SM-15/ERB-BSPD/Ltspice/README.md

# ERB-BSPD
BSPD Circuit and PCB by E-Racing Bergamo
