SM-15/ERB-BSPD/docs/Logic block diagram.png

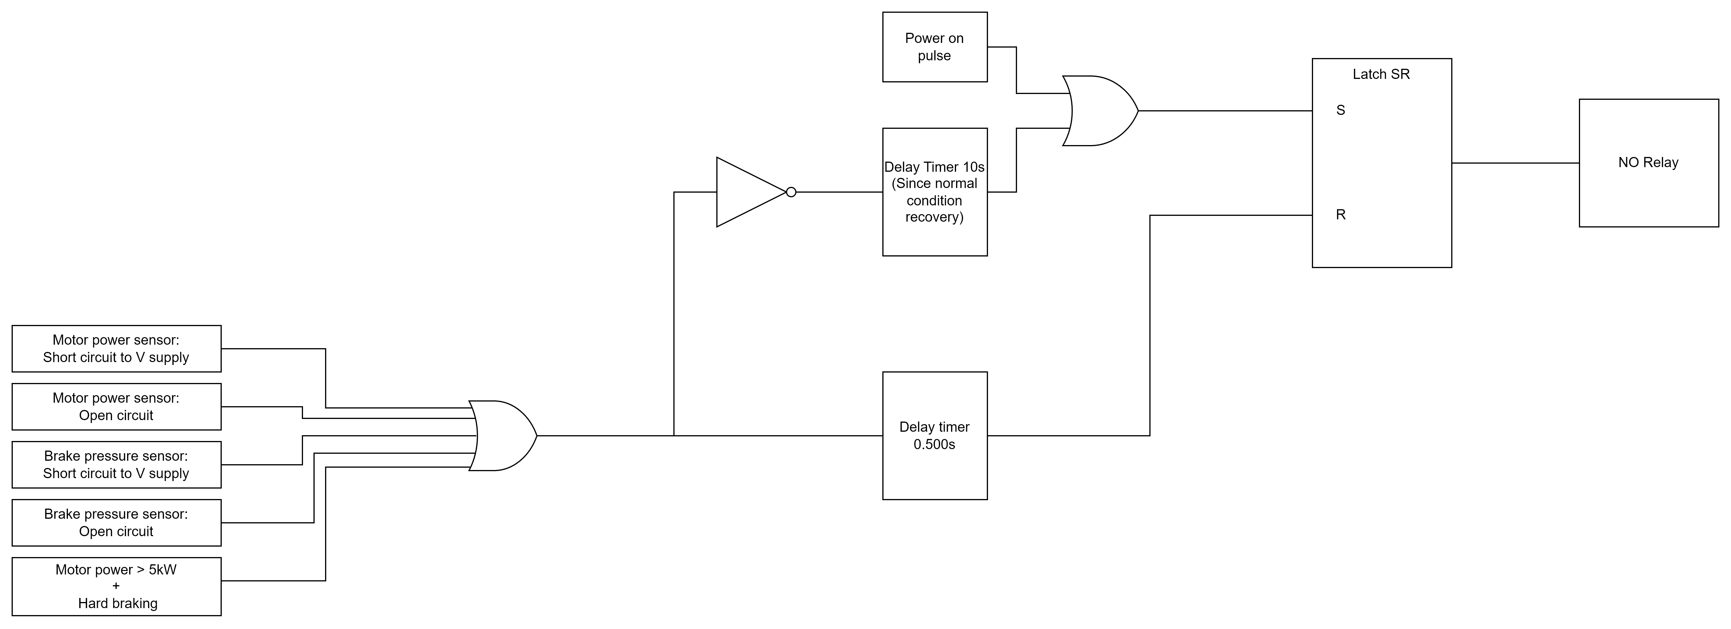
docs/Logic block diagram.png
