SM-15/ERB-BSPD/schemablocchi.png

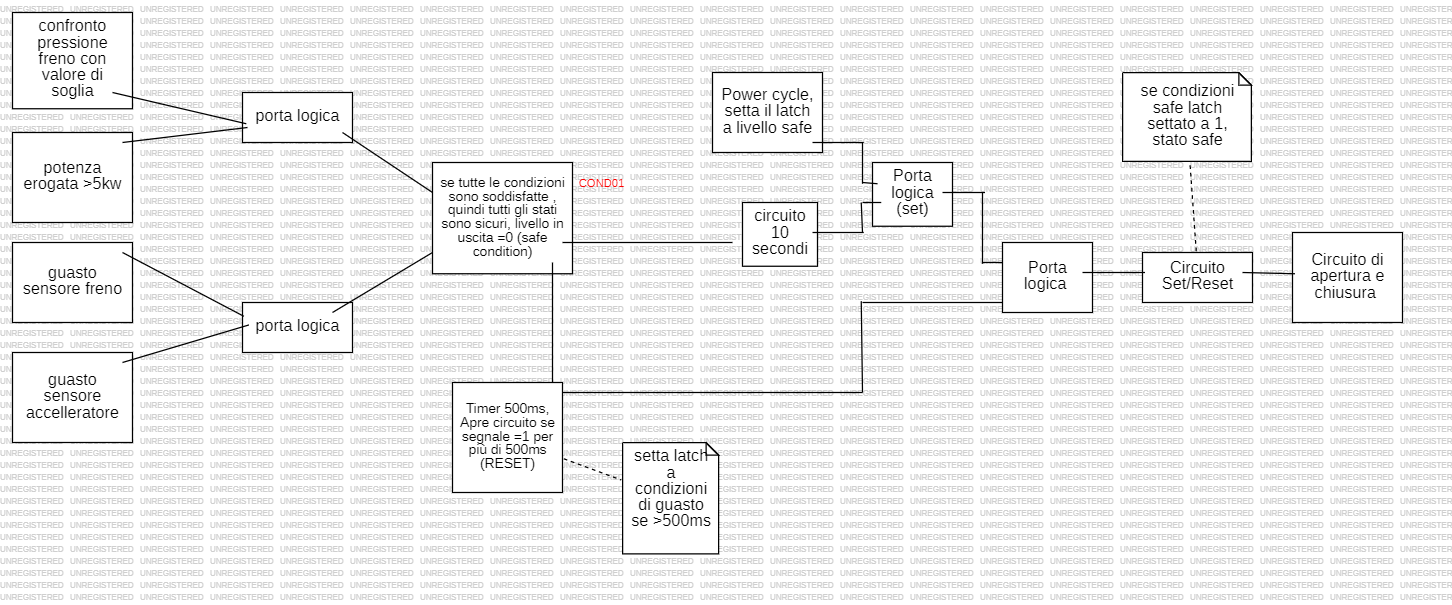
schemablocchi.png
