SM-15/ERB-BSPD/docs/System component overview.png

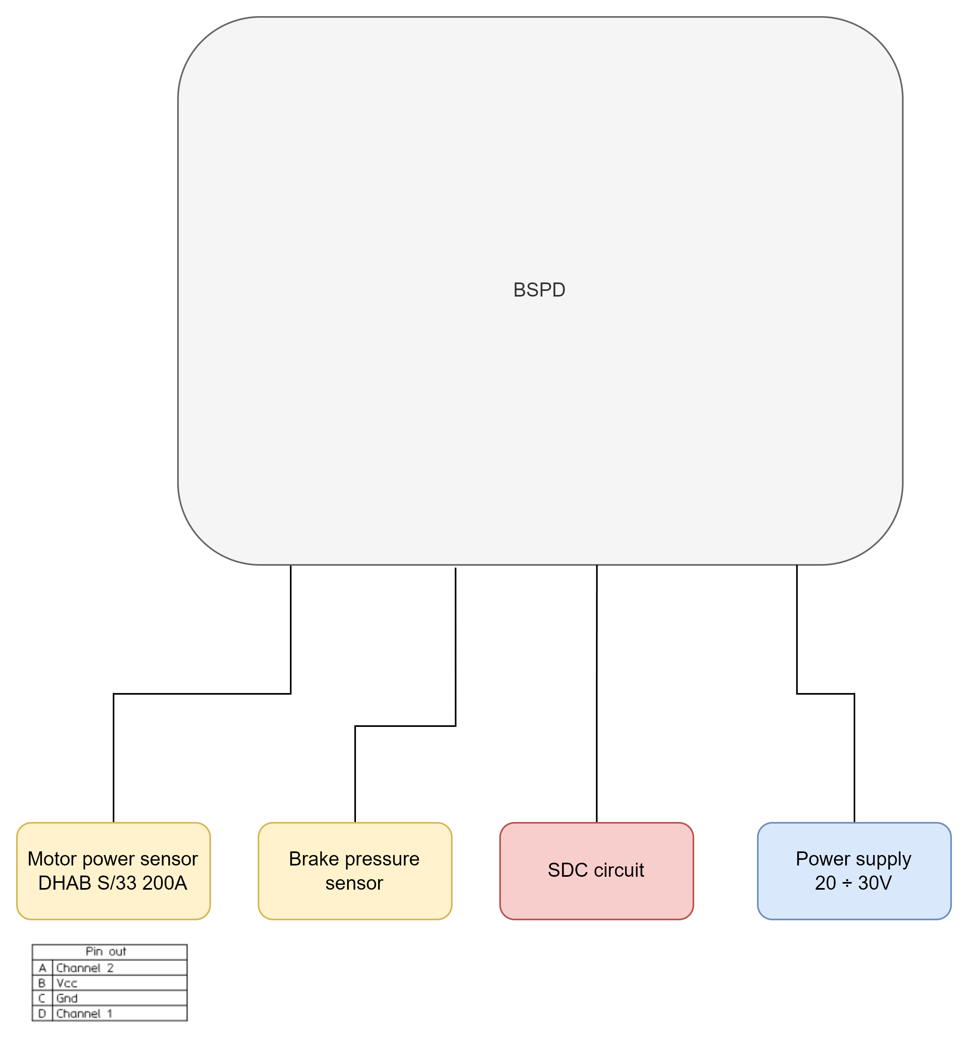
docs/System component overview.png
