SM-15/ERB-BSPD/docs/Schematic_ERB-BSPD_2024-05-10.pdf

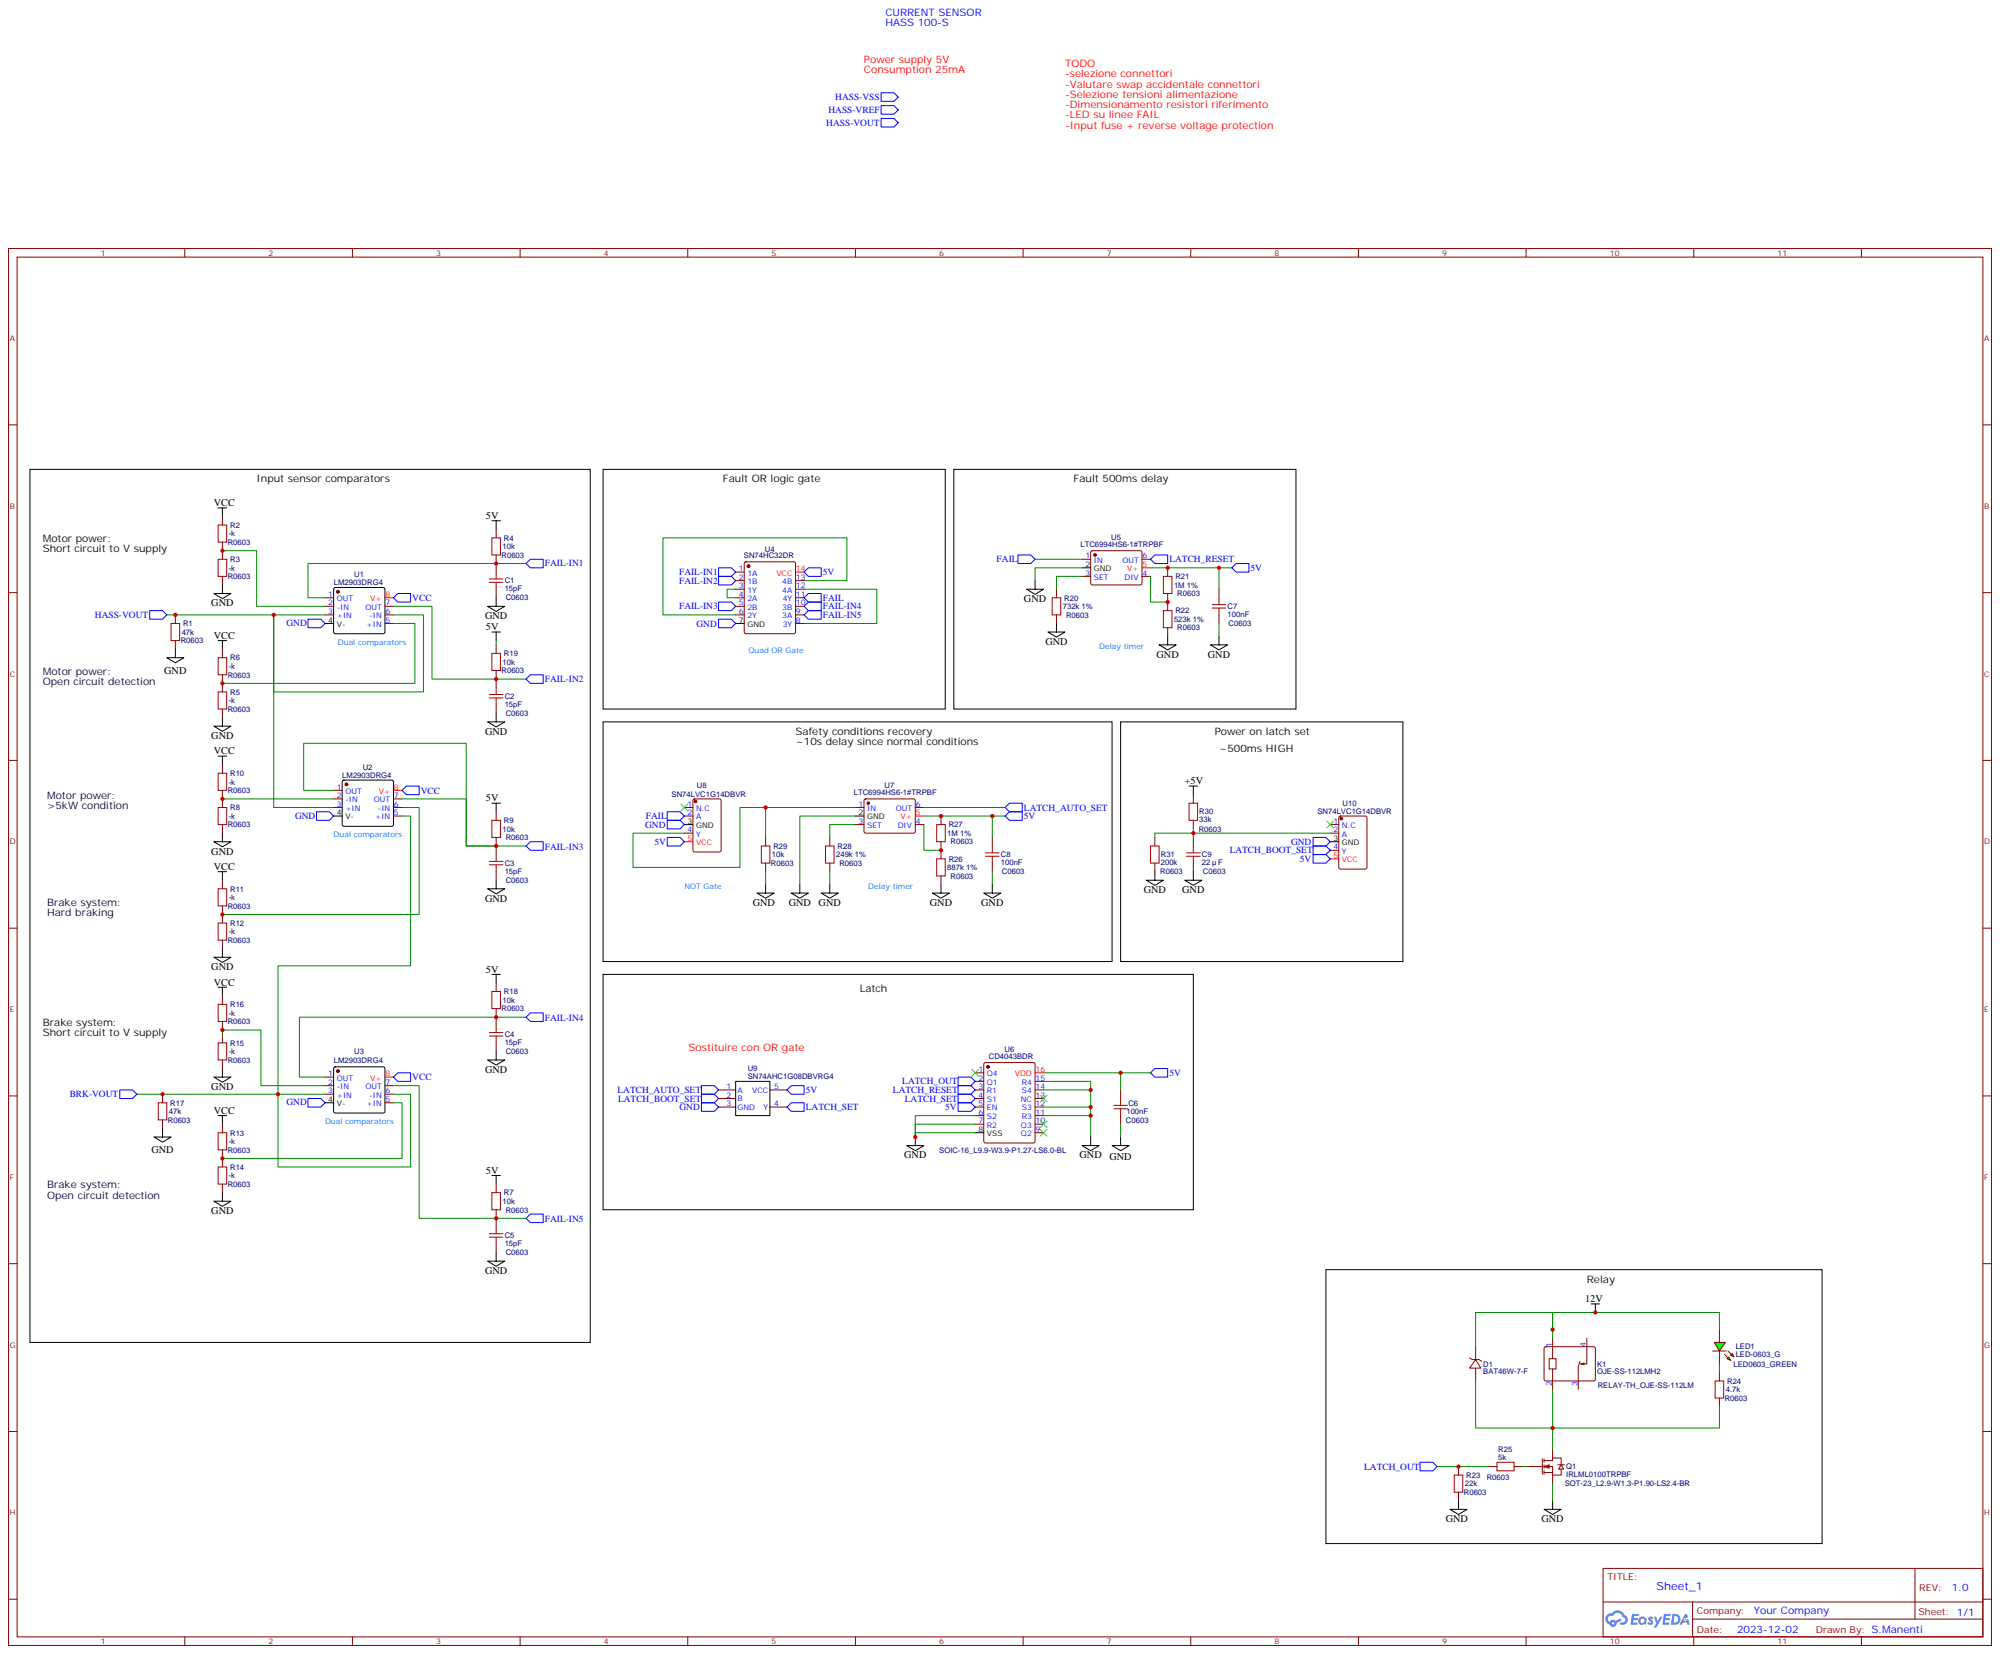
[picture p20: page 1]

TODO
-selezione connettori
-Valutare swap accidentale connettori
-Selezione tensioni alimentazione
-Dimensionamento resistori riferimento
-LED su linee FAIL
-Input fuse + reverse voltage protection

Motor power:
Short circuit to V supply

Delay timer Quad OR Gate

Safety conditions recovery
~10s delay since normal conditions

Power on latch set
~500ms HIGH

Brake system:

Sostituire con OR gate
