SM-15/ERB-BSPD/docs/BSPD LtSpice Circuit v8.pdf

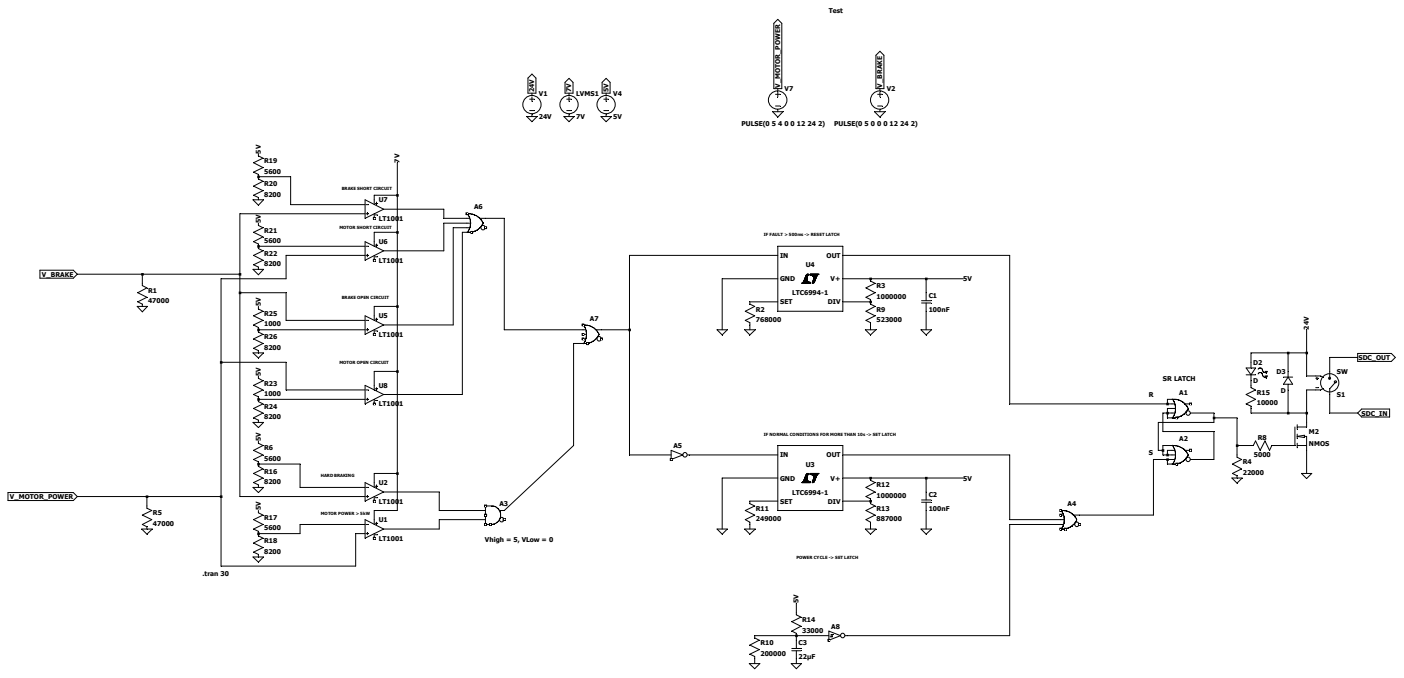
[picture p21: page 1]

IF FAULT > 500ms -> RESET LATCH

IF NORMAL CONDITIONS FOR MORE THAN 10s -> SET LATCH

POWER CYCLE -> SET LATCH
