SM-15/ERB-BSPD/Ltspice/BSPD_ERB.pdf

## LVMS2

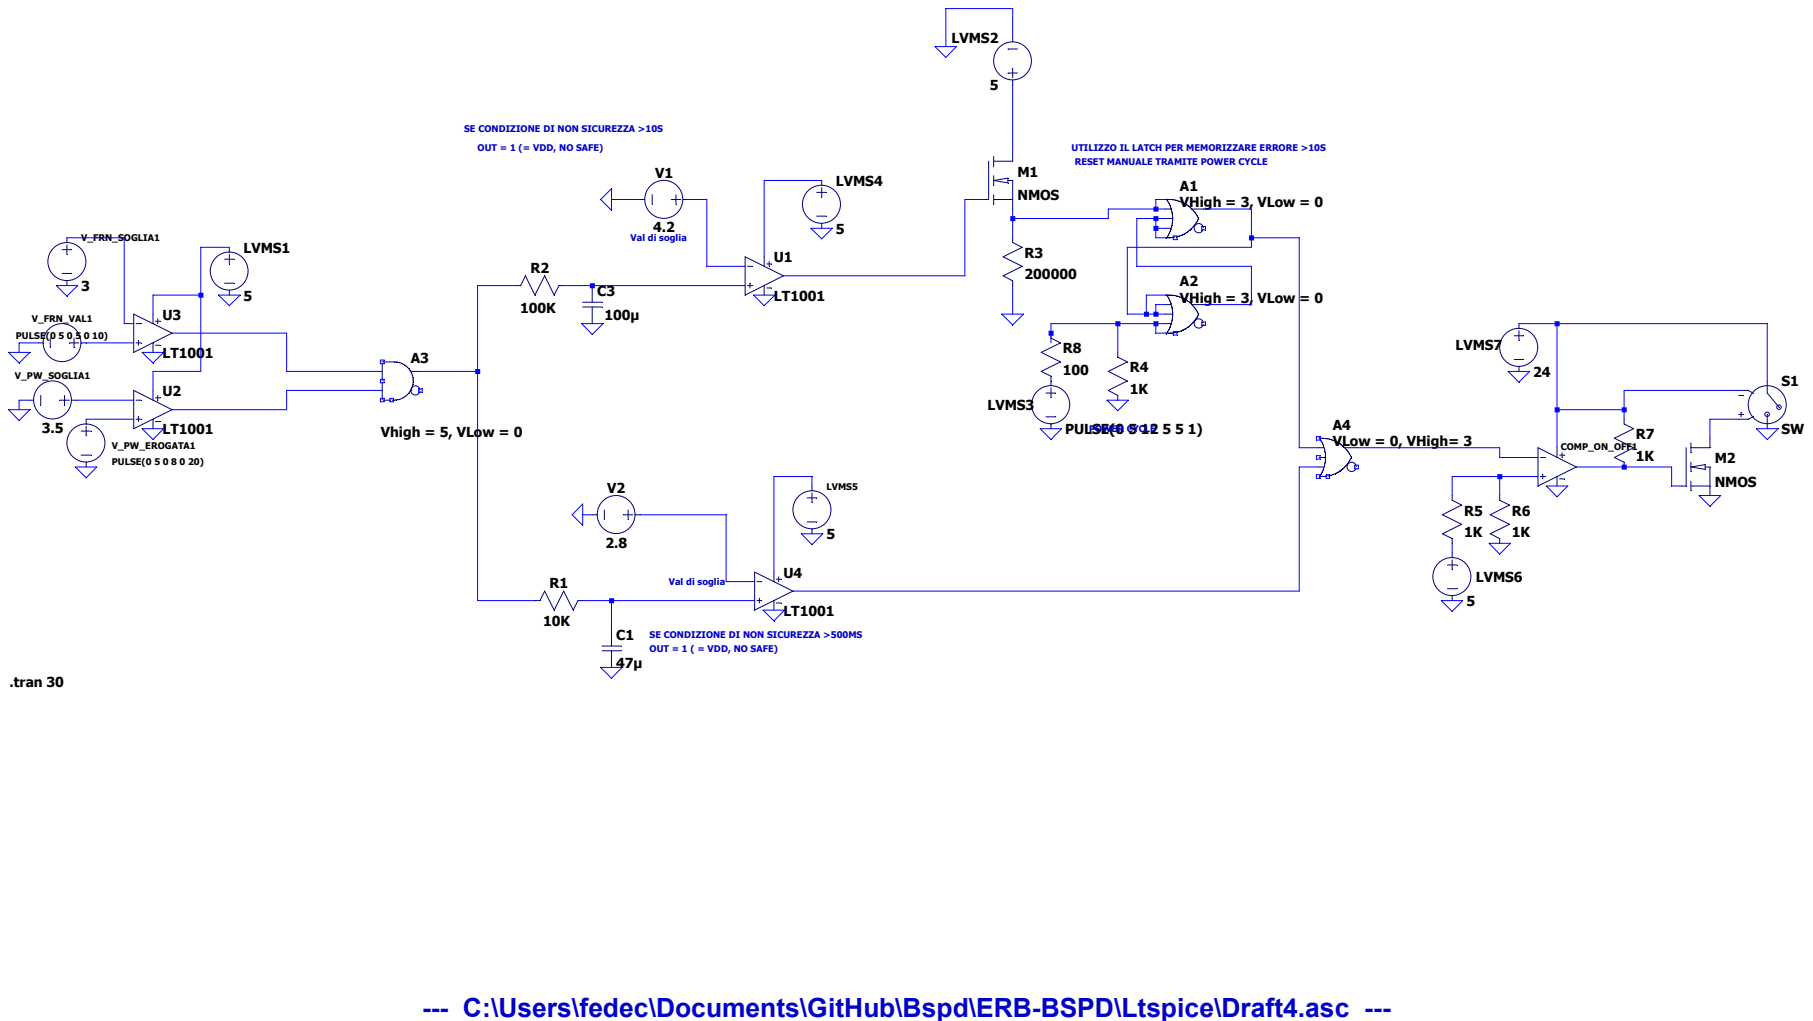
[picture p22: page 1]

SE CONDIZIONE DI NON SICUREZZA >10S

RESET MANUALE TRAMITE POWER CYCLE

SE CONDIZIONE DI NON SICUREZZA >500MS
OUT = 1 ( = VDD, NO SAFE)

--- C:\Users\fedec\Documents\GitHub\Bspd\ERB-BSPD\Ltspice\Draft4.asc ---
