SM-15/ERB-BSPD/Ltspice/generico01.pdf

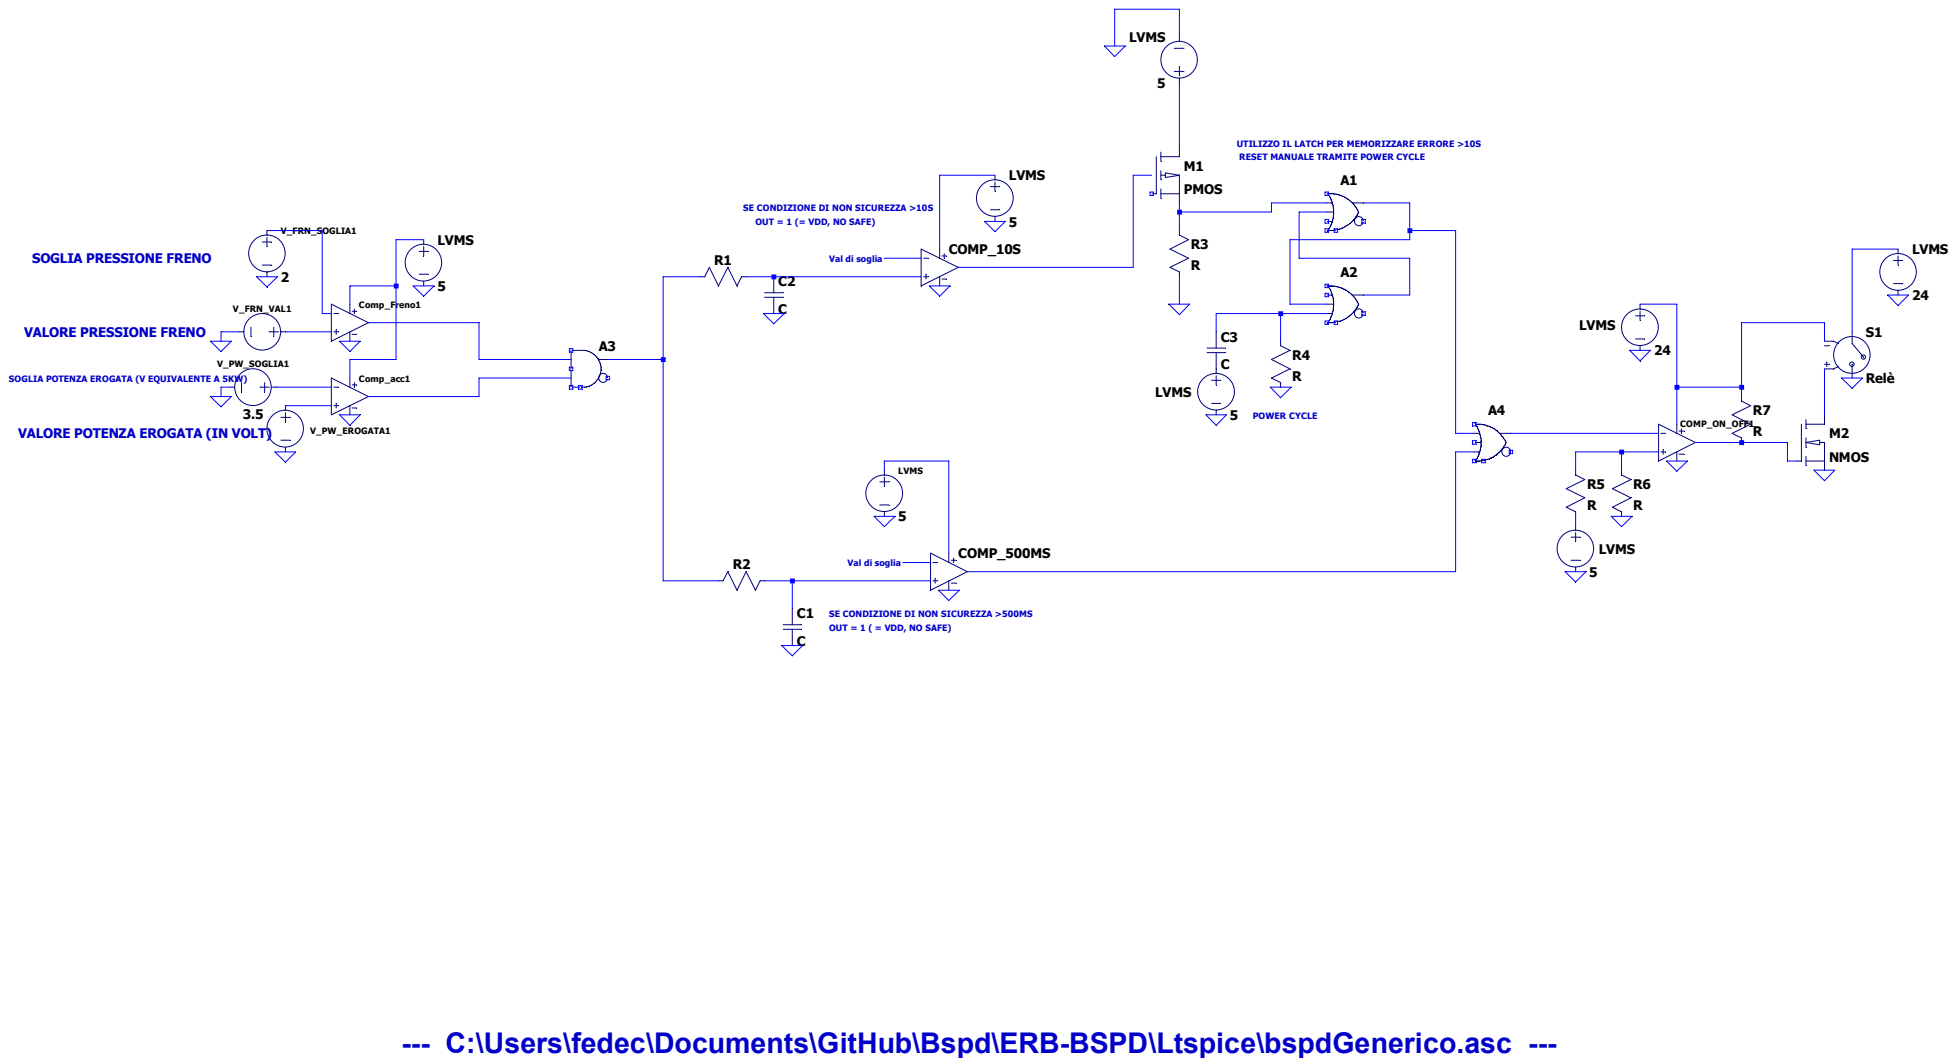
[picture p23: page 1]

UTILIZZO IL LATCH PER MEMORIZZARE ERRORE >10S
RESET MANUALE TRAMITE POWER CYCLE

SE CONDIZIONE DI NON SICUREZZA >10S
OUT = 1 (= VDD, NO SAFE)

SOGLIA POTENZA EROGATA (V EQUIVALENTE A 5KW)

VALORE POTENZA EROGATA (IN VOLT)

SE CONDIZIONE DI NON SICUREZZA >500MS
OUT = 1 ( = VDD, NO SAFE)

--- C:\Users\fedec\Documents\GitHub\Bspd\ERB-BSPD\Ltspice\bspdGenerico.asc ---
