SM-15/ERB-BSPD/docs/fsae-brake-system-plausibility-device.pdf

### Brake System Encoders

### Electronic Throttle Position Sensors

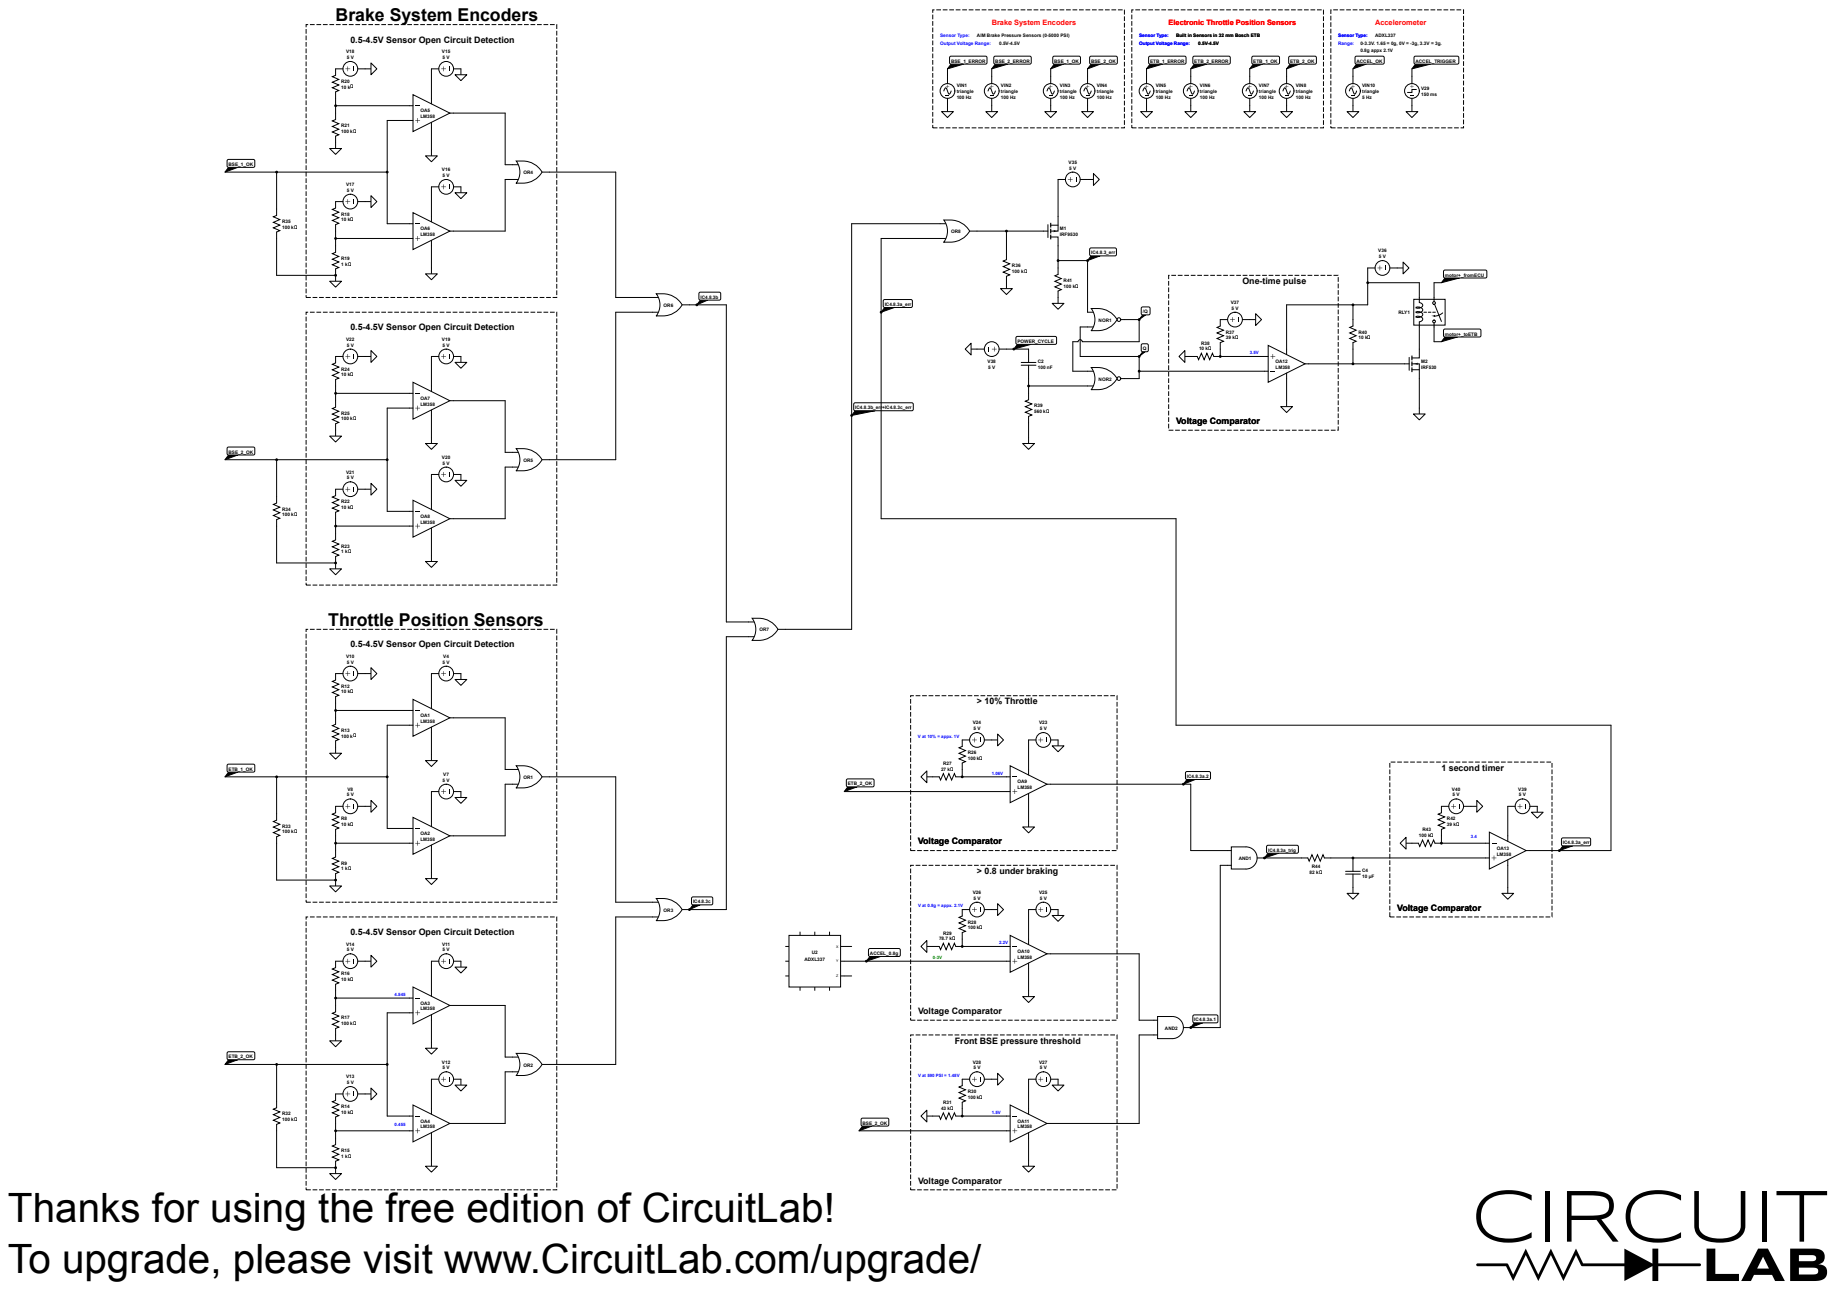
[picture p24: page 1]

0.5-4.5V Sensor Open Circuit Detection

Electronic Throttle Position Sensors

Front BSE pressure threshold

Thanks for using the free edition of CircuitLab!
To upgrade, please visit www.CircuitLab.com/upgrade/
