SM-15/ERB-BSPD/docs/Schematic ERB-BSPD.pdf

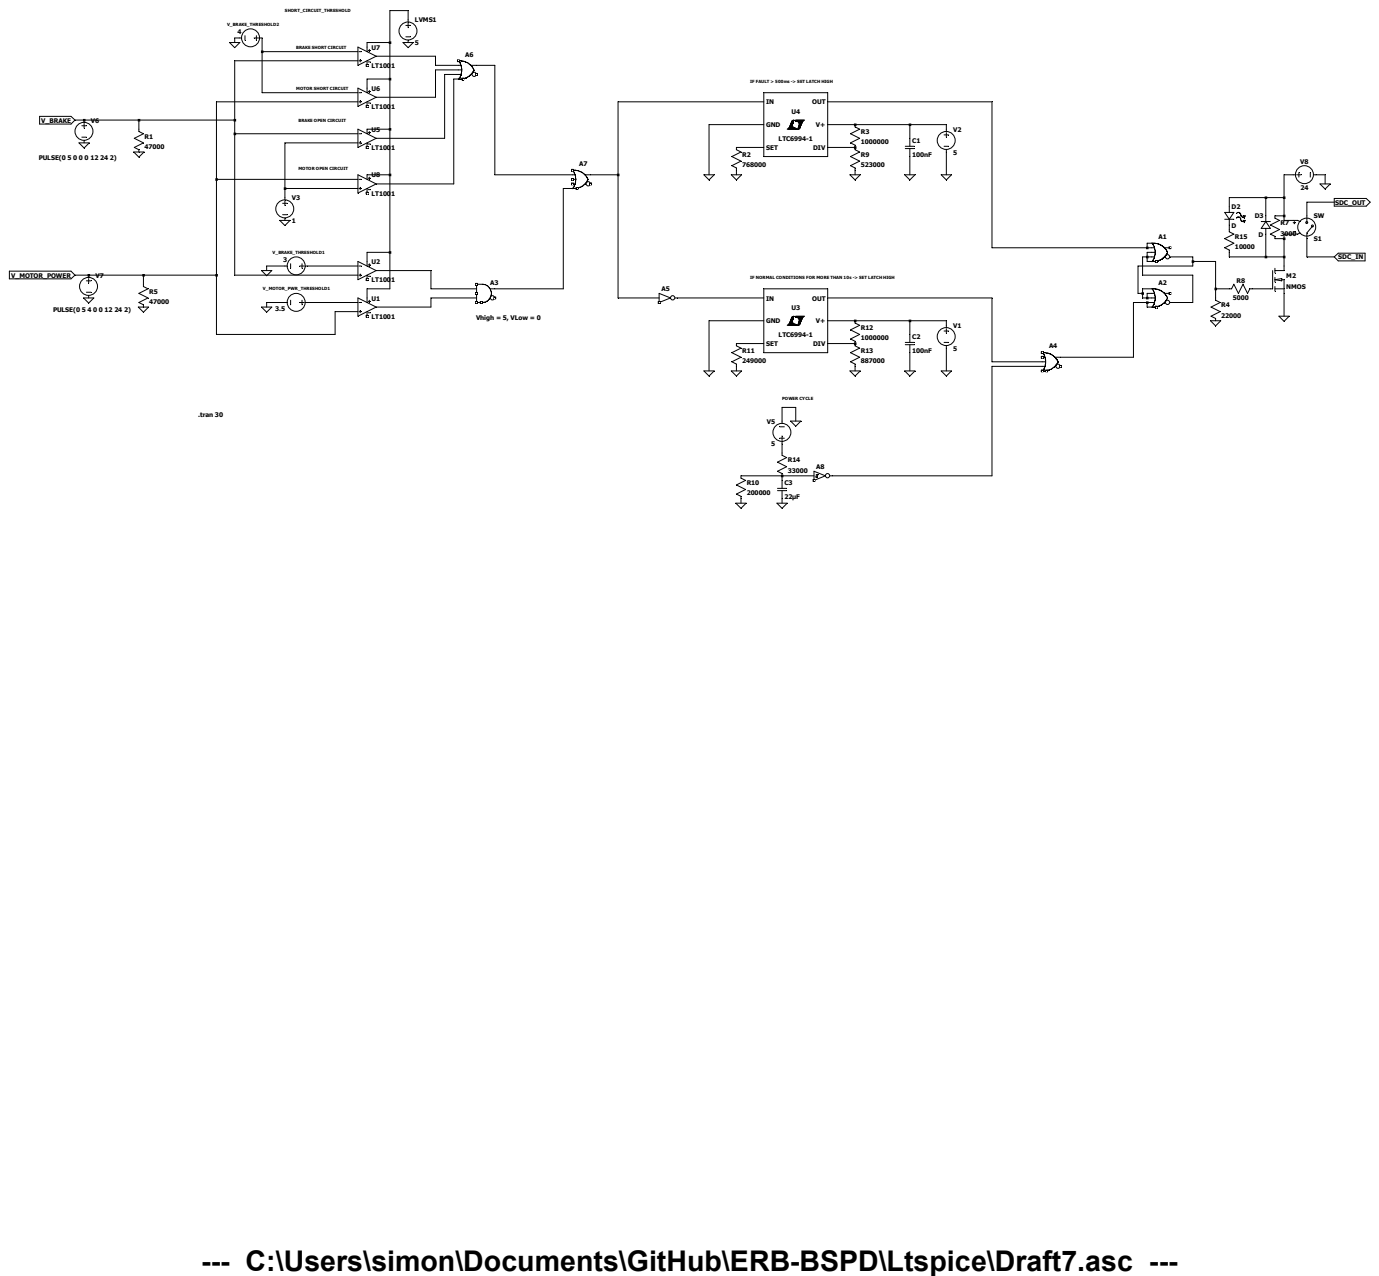
[picture p25: page 1]

IF FAULT > 500ms -> SET LATCH HIGH

IF NORMAL CONDITIONS FOR MORE THAN 10s -> SET LATCH HIGH

--- C:\Users\simon\Documents\GitHub\ERB-BSPD\Ltspice\Draft7.asc ---
