SM-15/ERB-BSPD/Ltspice/bspd_24.pdf

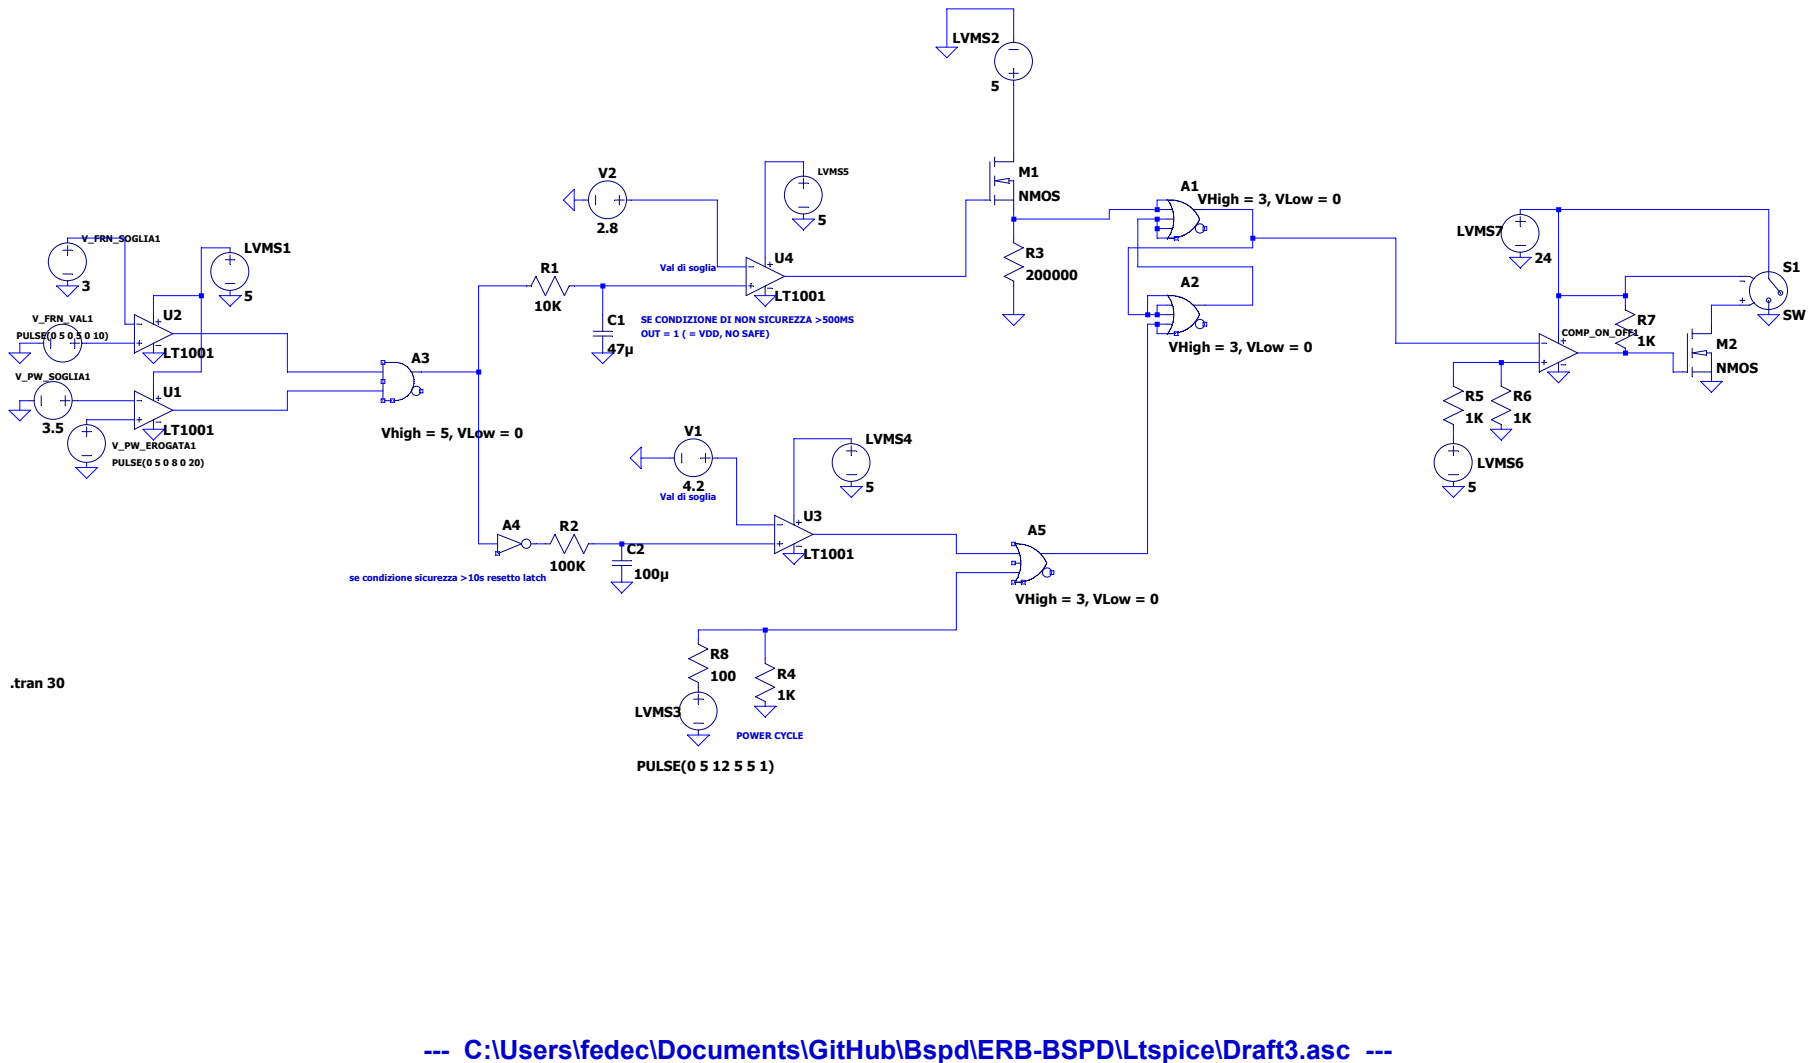
[picture p26: page 1]

SE CONDIZIONE DI NON SICUREZZA >500MS
OUT = 1 ( = VDD, NO SAFE)

se condizione sicurezza >10s resetto latch

--- C:\Users\fedec\Documents\GitHub\Bspd\ERB-BSPD\Ltspice\Draft3.asc ---
