SM-15/ERB-BSPD/Ltspice/BSPD_ERB24.pdf

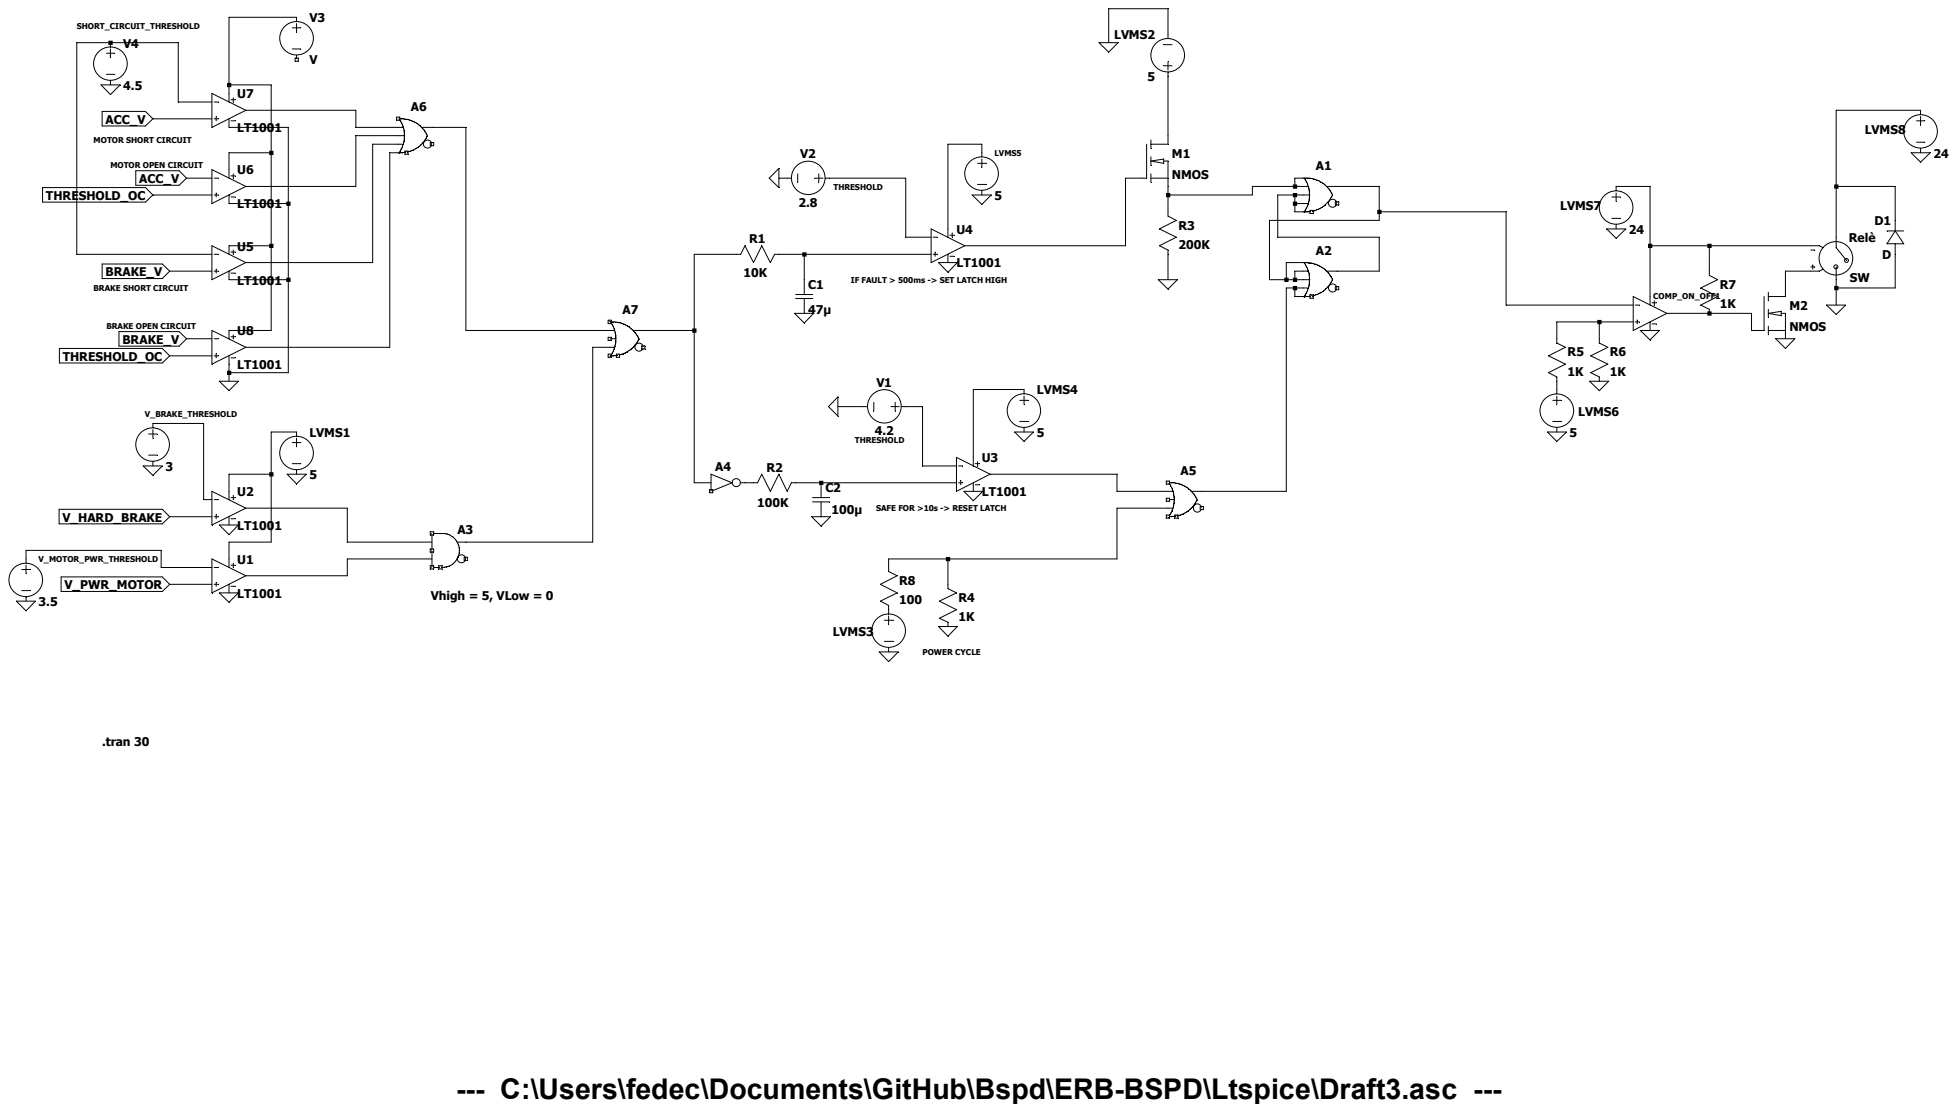
[picture p27: page 1]

SAFE FOR >10s -> RESET LATCH

--- C:\Users\fedec\Documents\GitHub\Bspd\ERB-BSPD\Ltspice\Draft3.asc ---
