SM-15/ERB-BSPD/Ltspice/LTC6994 10s delay circuit/LTC6994 Test Circuit.asc

R1: res; 10000; pwr=0.125
R2: res; 245000; tol=1 pwr=0.125
R3: res; 1000000; tol=1 pwr=0.125
R4: res; 887000; tol=1 pwr=0.125
U1: LTC6994-1
V1: voltage; 5
V2: voltage; PULSE(0 5 1 1u 1u 11 15 2)
Named nets: 0, OUTPUT
.tran 30
