SM-15/ERB-BSPD/Ltspice/Draft9.asc

A1: or
A2: or
C1: cap; 100nF; V=16
C2: cap; 100nF; V=16
C3: cap; 2.2µF
C4: cap; 2.2µF; V=50V
C5: cap; 100nF
C6: cap; 22µF; V=10
C7: cap; 100µF
C8: cap; 100nF; V=16
C9: cap; 100nF; V=16
C10: cap; 100nF; V=16
C11: cap; 100nF; V=16
C12: cap; 100nF; V=16
C13: cap; 100nF; V=16
D1: diode
D2: LED
D3: diode
D4: TVSdiode
D5: zener
D6: LED
L1: ind; 18µH
M1: pmos
M2: nmos
Q1: npn
R1: res; 47000
R2: res; 768000; tol=1 pwr=0.125
R3: res; 1000000; tol=1 pwr=0.125
R4: res; 22000
R5: res; 88700
R6: res; 22100
R7: res; 1200
R8: res; 5000
R9: res; 523000; tol=1 pwr=0.125
R10: res; 10000
R11: res; 249000; tol=1 pwr=0.125
R12: res; 1000000; tol=1 pwr=0.125
R13: res; 887000; tol=1 pwr=0.125
R14: res; 330000
R15: res; 10000; tol=5 pwr=0.125
R16: res; 100k
R17: res; 1000
R18: res; 100k
R19: res; 8200
R20: res; 4700
R21: res; 8200
R22: res; 4700
R23: res; 10000
R24: res; 1000
R25: res; 100k
R26: res; 100k
R27: res; 8200
R28: res; 8200
R29: res; 1800
R30: res; 1000
R31: res; 47000
R32: res; 1200
R33: res; 8200
R34: res; 8200
R35: res; 1800
R36: res; 100k
R37: res; 1000
R38: res; 100k
R39: res; 100k
R40: res; 10000; tol=5 pwr=0.125
S1: sw
U1: SN74LVC1G14
U2: SN74LVC1G32
U3: LTC6994-1
U4: LTC6994-1
U5: LT1001
U6: LT1001
U7: SN74LVC1G14
U9: LT1001
U10: LT1001
U11: LT1001
U12: LT1001
V1: voltage; 24V
V2: voltage; PULSE(0 5 0 0 0 12 24 2)
V7: voltage; PULSE(0 5 4 0 0 12 24 2)
X1: 
X2: Fuse
Named nets: V_MOTOR_POWER, 0, SDC_IN, SDC_OUT, 5V, VIN, 24V, V_BRAKE
POWER CYCLE -> SET LATCH
IF FAULT > 500ms -> RESET LATCH
IF NORMAL CONDITIONS FOR MORE THAN 10s -> SET LATCH
Test
SR LATCH
R
S
BRAKE 
OPEN CIRCUIT
BRAKE 
SHORT CIRCUIT 
TO VSUPPLY
½ MPC6547
½ MPC6547
MOTOR CURRENT
OPEN CIRCUIT
MOTOR CURRENT
SHORT CIRCUIT
TO VSUPPLY
½ MPC6547
½ MPC6547
POWER >5kW
HARD BRAKING
½ MPC6547
½ MPC6547
HIGH: Ok
LOW: Err
X7R 50V
X7R 10V
5V Step down
BULK 50V
Decoupling capacitors
VIN 20÷30V
