SM-15/ERB-BSPD/Ltspice/Draft7.asc

A1: or
A2: or
A3: and; Vhigh = 5, VLow = 0
A4: or
A5: inv
A6: or
A7: or
A8: schmtinv
C1: cap; 100nF; V=16
C2: cap; 100nF; V=16
C3: cap; 22µF
D2: LED
D3: diode
LVMS1: voltage; 7V
M2: nmos
R1: res; 47000
R2: res; 768000; tol=1 pwr=0.125
R3: res; 1000000; tol=1 pwr=0.125
R4: res; 22000
R5: res; 47000
R6: res; 5600
R7: res; 3000
R8: res; 5000
R9: res; 523000; tol=1 pwr=0.125
R10: res; 200000
R11: res; 249000; tol=1 pwr=0.125
R12: res; 1000000; tol=1 pwr=0.125
R13: res; 887000; tol=1 pwr=0.125
R14: res; 33000
R15: res; 10000; tol=5 pwr=0.125
R16: res; 8200
R17: res; 5600
R18: res; 8200
R19: res; 5600
R20: res; 8200
R21: res; 5600
R22: res; 8200
R23: res; 1000
R24: res; 8200
R25: res; 1000
R26: res; 8200
S1: sw
U1: LT1001
U2: LT1001
U3: LTC6994-1
U4: LTC6994-1
U5: LT1001
U6: LT1001
U7: LT1001
U8: LT1001
V1: voltage; 24V
V2: voltage; PULSE(0 5 0 0 0 12 24 2)
V4: voltage; 5V
V7: voltage; PULSE(0 5 4 0 0 12 24 2)
Named nets: V_BRAKE, V_MOTOR_POWER, 0, SDC_IN, SDC_OUT, 5V, 7V, 24V
POWER CYCLE -> SET LATCH
MOTOR SHORT CIRCUIT
BRAKE SHORT CIRCUIT
MOTOR OPEN CIRCUIT
BRAKE OPEN CIRCUIT
IF FAULT > 500ms -> RESET LATCH
.tran 30
IF NORMAL CONDITIONS FOR MORE THAN 10s -> SET LATCH
Test
HARD BRAKING
MOTOR POWER > 5kW
