SM-15/ERB-BSPD/Ltspice/Draft8.asc

A1: or
A2: or
A4: or
A5: inv
A7: or
A8: schmtinv
C1: cap; 100nF; V=16
C2: cap; 100nF; V=16
C3: cap; 22µF
C4: cap; 2.2µF; V=50V
C5: cap; 100nF
C6: cap; 22µF; V=10
C7: cap; 100µF
D2: LED
D3: diode
L1: ind; 18µH
M2: nmos
R1: res; 47000
R2: res; 768000; tol=1 pwr=0.125
R3: res; 1000000; tol=1 pwr=0.125
R4: res; 22000
R5: res; 88700
R6: res; 22100
R7: res; 5600
R8: res; 5000
R9: res; 523000; tol=1 pwr=0.125
R10: res; 200000
R11: res; 249000; tol=1 pwr=0.125
R12: res; 1000000; tol=1 pwr=0.125
R13: res; 887000; tol=1 pwr=0.125
R14: res; 33000
R15: res; 10000; tol=5 pwr=0.125
R19: res; 8200
R20: res; 4700
R21: res; 8200
R22: res; 4700
R23: res; 10000
R27: res; 8200
R28: res; 1000
R29: res; 8200
R30: res; 10000
R31: res; 47000
R32: res; 5600
R33: res; 8200
R34: res; 1000
R35: res; 8200
R36: res; 10000
R37: res; 10000
R38: res; 10000
S1: sw
U3: LTC6994-1
U4: LTC6994-1
U5: LT1001
U6: LT1001
U9: LT1001
U10: LT1001
U11: LT1001
U12: LT1001
V1: voltage; 24V
V2: voltage; PULSE(0 5 0 0 0 12 24 2)
V7: voltage; PULSE(0 5 4 0 0 12 24 2)
X1: 
Named nets: V_MOTOR_POWER, 0, SDC_IN, SDC_OUT, 5V, 24V, V_BRAKE, FAIL_1, FAIL_2, FAIL_4, FAIL_3, FAIL_5
POWER CYCLE -> SET LATCH
IF FAULT > 500ms -> RESET LATCH
IF NORMAL CONDITIONS FOR MORE THAN 10s -> SET LATCH
Test
SR LATCH
R
S
BRAKE 
OPEN CIRCUIT
BRAKE 
SHORT CIRCUIT 
TO VSUPPLY
½ MPC6547
½ MPC6547
MOTOR CURRENT
OPEN CIRCUIT
MOTOR CURRENT
SHORT CIRCUIT
TO VSUPPLY
½ MPC6547
½ MPC6547
POWER >5kW
HARD BRAKING
½ MPC6547
½ MPC6547
HIGH: Err
LOW: OK
X7R 50V
X7R 10V
5V Step down
BULK 50V
