SM-15/ERB-BSPD/Ltspice/Draft6.asc

A1: or
A2: or
A3: and; Vhigh = 5, VLow = 0
A4: or
A5: inv
A6: or
A7: or
C1: cap; 4.7µ
C2: cap; 1n
C3: cap; 10n
C4: cap; 100µ; V=4 Irms=0 Rser=0 Lser=0 mfg="Murata" pn="GRM21BR60G107ME11" type="X5R"
COMP_ON_OFF1: UniversalOpAmp
D1: diode
LVMS1: voltage; 5
LVMS3: voltage; ""
LVMS4: voltage; 5
LVMS6: voltage; 5
LVMS7: voltage; 24
LVMS8: voltage; 24
M2: nmos
Q1: npn
R1: res; 10k
R2: res; 10k
R3: res; 100k
R4: res; 1K; tol=1 pwr=0.1
R5: res; 1K; tol=1 pwr=0.1
R6: res; 1K; tol=1 pwr=0.1
R7: res; 1K; tol=1 pwr=0.1
R8: res; 100
R9: res; 1k
R10: res; 10k
R11: res; 100K; tol=1 pwr=0.1
R12: res; 100k
U1: LT1001
U2: LT1001
U3: LT1001
U4: NE555
U5: LT1001
U6: LT1001
U7: LT1001
U8: LT1001
V1: voltage; 4
V2: voltage; 5
V3: voltage
V4: voltage; 3
V5: voltage; 5
V6: voltage; PULSE(0 5 0 0 0 12 24 2)
V7: voltage; PULSE(0 5 4 0 0 12 24 2)
V_BRAKE_THRESHOLD1: voltage; 3
V_MOTOR_PWR_THRESHOLD1: voltage; 3.5
Named nets: 0, ACC_V, BRAKE_V, V_HARD_BRAKE, V_PWR_MOTOR, THRESHOLD_OC
POWER CYCLE
THRESHOLD
MOTOR SHORT CIRCUIT
BRAKE SHORT CIRCUIT
MOTOR OPEN CIRCUIT
BRAKE OPEN CIRCUIT
SHORT_CIRCUIT_THRESHOLD
SAFE FOR >10s -> RESET LATCH
IF FAULT > 500ms -> SET LATCH HIGH
.tran 30
