SM-15/ERB-BSPD/Ltspice/CircuioTimerbspd.asc

A1: or
A2: or
A3: and; Vhigh = 5, VLow = 0
A4: inv
A5: or
A6: or
A7: or
C1: cap; 47µ; V=4 Irms=0 Rser=0 Lser=0 mfg="Murata" pn="GRM219R60G476ME44" type="X5R"
C2: cap; 100µ; V=4 Irms=0 Rser=0 Lser=0 mfg="Murata" pn="GRM21BR60G107ME11" type="X5R"
COMP_ON_OFF1: UniversalOpAmp
D1: diode
LVMS1: voltage; 5
LVMS2: voltage; 5
LVMS3: voltage; ""
LVMS4: voltage; 5
LVMS5: voltage; 5
LVMS6: voltage; 5
LVMS7: voltage; 24
LVMS8: voltage; 24
M1: nmos
M2: nmos
R1: res; 10K; tol=1 pwr=0.1
R2: res; 100K; tol=1 pwr=0.1
R3: res; 200K; tol=1 pwr=0.1
R4: res; 1K; tol=1 pwr=0.1
R5: res; 1K; tol=1 pwr=0.1
R6: res; 1K; tol=1 pwr=0.1
R7: res; 1K; tol=1 pwr=0.1
R8: res; 100
R9: res; 100k
R10: res; 10k
U1: LT1001
U2: LT1001
U3: LT1001
U4: LT1001
U5: LT1001
U6: LT1001
U7: LT1001
U8: LT1001
V1: voltage; 4.2
V2: voltage; 2.8
V3: voltage
V4: voltage; PWL(5 0 15 5 5 0)
V_BRAKE_THRESHOLD: voltage; 3
V_MOTOR_PWR_THRESHOLD: voltage; 3.5
Named nets: 0, ACC_V, BRAKE_V, V_HARD_BRAKE, V_PWR_MOTOR, THRESHOLD_OC
POWER CYCLE
THRESHOLD
THRESHOLD
.tran 30
MOTOR SHORT CIRCUIT
BRAKE SHORT CIRCUIT
MOTOR OPEN CIRCUIT
BRAKE OPEN CIRCUIT
SHORT_CIRCUIT_THRESHOLD
SAFE FOR >10s -> RESET LATCH
IF FAULT > 500ms -> SET LATCH HIGH
