SM-15/ERB-BSPD/Ltspice/bspd.asc

A1: or
A2: or
A3: or
A4: and
A5: or
A6: or
A7: or
A8: or
C1: cap
C2: cap
C3: cap
COMP_10S: UniversalOpAmp
COMP_500MS: UniversalOpAmp
Comp_acc: UniversalOpAmp
Comp_Freno: UniversalOpAmp
COMP_ON_OFF: UniversalOpAmp
M1: pmos
M2: nmos
R1: res; ""
R2: res; ""
R4: res
R5: res
R6: res
R7: res
R8: res
R9: res
R10: res
S1: sw; Relè
SOGLIA_1S: voltage; 5
SOGLIA_500MS: voltage; 5
U1: UniversalOpAmp
U2: UniversalOpAmp
U3: UniversalOpAmp
U4: UniversalOpAmp
U9: LT1720
V1: voltage; 5
V2: voltage; 5
V3: voltage; 5
V4: voltage; 5
V5: voltage; 5
V6: voltage
V7: voltage; 24
V10: voltage; 24
V_FRN_SOGLIA: voltage; 2
V_FRN_VAL: voltage; ""
V_PW_EROGATA: voltage; ""
V_PW_SOGLIA: voltage; 3.5
Named nets: 0
VALORE PRESSIONE FRENO
val freno < soglia max out=0
val freno > soglia min, out = 0
val acc < soglia max, out = 0
SE CONDIZIONE DI NON SICUREZZA >10S
0 = condizione safe
val acc > soglia min, out = 0
soglia max
soglia max
SOGLIA PRESSIONE FRENO
soglia min
SOGLIA POTENZA EROGATA (V EQUIVALENTE A 5KW)
soglia min
UTILIZZO IL LATCH PER MEMORIZZARE ERRORE >10S
.tran 10
VALORE POTENZA EROGATA (IN VOLT)
OUT = 1 (= VDD, NO SAFE)
SE CONDIZIONE DI NON SICUREZZA >500MS
OUT = 1 ( = VDD, NO SAFE)
RESET MANUALE TRAMITE POWER CYCLE
POWER CYCLE
Val di soglia
Val di soglia
