SM-15/ERB-BSPD/Ltspice/bspdGenerico.asc

A1: or
A2: or
A3: and
A4: or
C1: polcap; 100µ; V=3 Irms=2.25389 Rser=0.025 Lser=0 mfg="KEMET" pn="T520B107M003ATE025" type="Tantalum"
C2: cap; 47µ; V=4 Irms=0 Rser=0 Lser=0 mfg="Murata" pn="GRM219R60G476ME44" type="X5R"
C3: cap
COMP_10S: UniversalOpAmp
COMP_500MS: UniversalOpAmp
Comp_acc1: UniversalOpAmp
Comp_Freno1: UniversalOpAmp
LVMS01: voltage; 5
LVMS02: voltage; 5
LVMS03: voltage; 5
LVMS04: voltage; 5
LVMS: voltage; 5
M1: pmos
R1: res; 10K; tol=1 pwr=0.1
R2: res; 100K; tol=1 pwr=0.1
R3: res; 1K; tol=1 pwr=0.1
R4: res; 1K; tol=1 pwr=0.1
V1: voltage; 3.8
V2: voltage; 2.8
V_FRN_SOGLIA1: voltage; 2
V_FRN_VAL1: voltage; ""
V_PW_EROGATA1: voltage; ""
V_PW_SOGLIA1: voltage; 3.5
Named nets: 0
VALORE PRESSIONE FRENO
SE CONDIZIONE DI NON SICUREZZA >10S
SOGLIA PRESSIONE FRENO
SOGLIA POTENZA EROGATA (V EQUIVALENTE A 5KW)
UTILIZZO IL LATCH PER MEMORIZZARE ERRORE >10S
VALORE POTENZA EROGATA (IN VOLT)
OUT = 1 (= VDD, NO SAFE)
SE CONDIZIONE DI NON SICUREZZA >500MS
OUT = 1 ( = VDD, NO SAFE)
RESET MANUALE TRAMITE POWER CYCLE
POWER CYCLE
Val di soglia
Val di soglia
.tran 30
