SM-15/ERB-BSPD/Ltspice/Draft1.asc

M1: pmos; IRF9640
M2: pmos; IRF9640
M3: nmos; BSP89
M4: nmos; BSP89
M5: pmos; IRF9640
M6: nmos; BSP89
U1: LT1720
U2: LT1720
V1: voltage; 5
V2: voltage; 2
V3: voltage; PULSE(0 5 0 5 5 10 20)
V4: voltage; 3.5
V5: voltage; PULSE(0 5 0 5 5 10 20)
V6: voltage; 5
Named nets: 0, andOutput
hard braking < soglia max, out = 0
potenza erogata < 5kw, out = 0
soglia max
5kW
.tran 10
