SM-15/ERB-BSPD/Ltspice/Draft2.asc

A1: and
A2: or
C1: cap; 10µ; V=6.3 Irms=0 Rser=0.003 Lser=828p
C2: cap; 47µ; V=6.3 Irms=0 Rser=0.003 Lser=828p mfg="Würth Elektronik" pn="885012108004 WCAP-CSGP 1206" type="X5R"
R1: res; 100K; tol=1 pwr=0.1
R2: res; 10K; tol=1 pwr=0.1
U1: LT1720
U2: LT1720
U3: LT1720
U4: LT1720
V1: voltage; 5
V2: voltage; 2
V3: voltage; PULSE(0 5 0 5 5 10 20 2)
V4: voltage; 3.5
V5: voltage; PULSE(0 5 0 5 5 10 20 2)
V6: voltage; 5
V7: voltage; 5
Named nets: 0, andout, norout
hard braking < soglia max, out = 0
potenza erogata < 5kw, out = 0
soglia max
5kW
.tran 10
>500ms errore, out = 1
>10s no safe, out=1
