SM-15/ERB-BSPD/Ltspice/Draft4.asc

A1: or; VHigh = 3, VLow = 0
A2: or; VHigh = 3, VLow = 0
A3: and; Vhigh = 5, VLow = 0
A4: or; VLow = 0, VHigh= 3
C1: cap; 47µ; V=4 Irms=0 Rser=0 Lser=0 mfg="Murata" pn="GRM219R60G476ME44" type="X5R"
C3: cap; 100µ; V=4 Irms=0 Rser=0 Lser=0 mfg="Murata" pn="GRM21BR60G107ME11" type="X5R"
COMP_ON_OFF1: UniversalOpAmp
LVMS1: voltage; 5
LVMS2: voltage; 5
LVMS3: voltage; PULSE(0 5 12 5 5 1)
LVMS4: voltage; 5
LVMS5: voltage; 5
LVMS6: voltage; 5
LVMS7: voltage; 24
M1: nmos
M2: nmos
R1: res; 10K; tol=1 pwr=0.1
R2: res; 100K; tol=1 pwr=0.1
R3: res; 200000; tol=1 pwr=0.1
R4: res; 1K; tol=1 pwr=0.1
R5: res; 1K; tol=1 pwr=0.1
R6: res; 1K; tol=1 pwr=0.1
R7: res; 1K; tol=1 pwr=0.1
R8: res; 100
S1: sw
U1: LT1001
U2: LT1001
U3: LT1001
U4: LT1001
V1: voltage; 4.2
V2: voltage; 2.8
V_FRN_SOGLIA1: voltage; 3
V_FRN_VAL1: voltage; PULSE(0 5 0 5 0 10)
V_PW_EROGATA1: voltage; PULSE(0 5 0 8 0 20)
V_PW_SOGLIA1: voltage; 3.5
Named nets: 0
SE CONDIZIONE DI NON SICUREZZA >10S
UTILIZZO IL LATCH PER MEMORIZZARE ERRORE >10S
OUT = 1 (= VDD, NO SAFE)
SE CONDIZIONE DI NON SICUREZZA >500MS
OUT = 1 ( = VDD, NO SAFE)
RESET MANUALE TRAMITE POWER CYCLE
POWER CYCLE
Val di soglia
Val di soglia
.tran 30
