SM-15/ERB-BSPD/Ltspice/Draft5.asc

D1: schottky; 1N5817
D2: diode; 1N914
R1: res; 1k
R2: res; 1k
V2: voltage; SINE(0 1 1k); AC 1
Named nets: 0
.tran 2ms
