SM-15/ERB-BSPD/Ltspice/LTC6994 500ms delay circuit/LTC6994 500ms delay circuit.asc

R2: res; 768000; tol=1 pwr=0.125
R3: res; 1000000; tol=1 pwr=0.125
R4: res; 523000; tol=1 pwr=0.125
U1: LTC6994-1
V1: voltage; 5
V2: voltage; PULSE(0 5 1 1u 1u 2 3 2)
Named nets: 0, OUTPUT, IN
.tran 30
