SM-15/ERB-BSPD/(commit log)

2023-11-30 Create Note di progettazione.docx
2023-11-30 Update Note di progettazione.docx
2023-12-06 documentazione e schema a blocchi
    preview
    [kicadCircuitBspd.kicad_pcb, kicadCircuitBspd.kicad_sch]
2024-03-06 da aggiungere relay e valori V, R
2024-05-16 Update LTSpice Schematic
